omarelsobkey/Power-Supply/PCB/+V,_15,_5,_-5,_-15,_-V_2.png

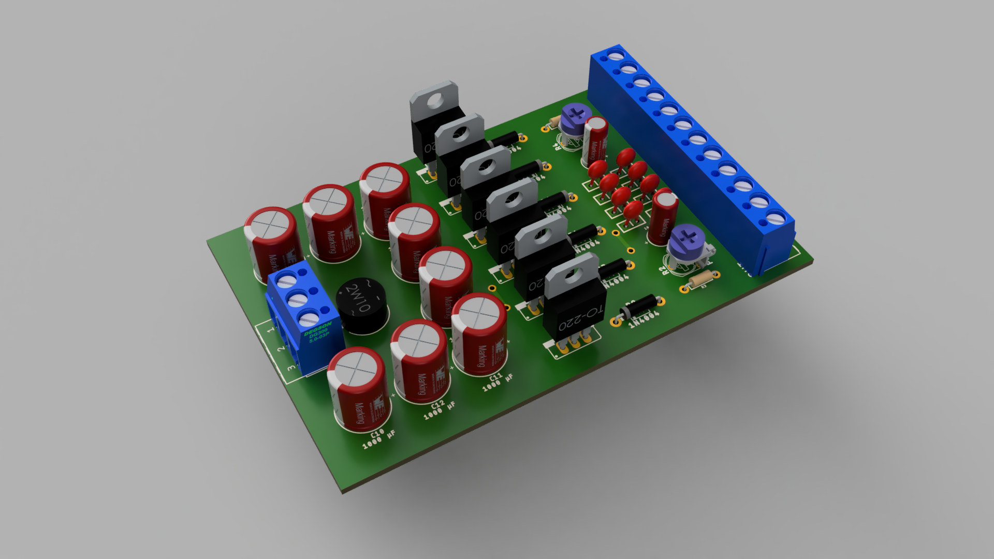
PCB/+V,_15,_5,_-5,_-15,_-V_2.png
