omarelsobkey/Power-Supply/PCB/+V, 15, 5, -5,-15, -V_1.png

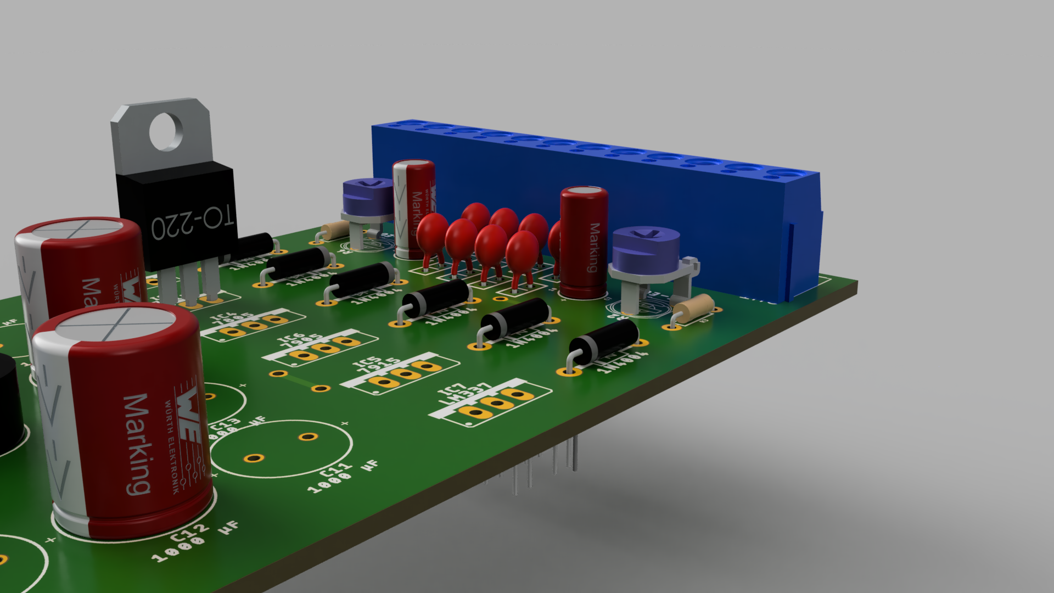
PCB/+V, 15, 5, -5,-15, -V_1.png
