omarelsobkey/Power-Supply/PCB/Done.jpeg

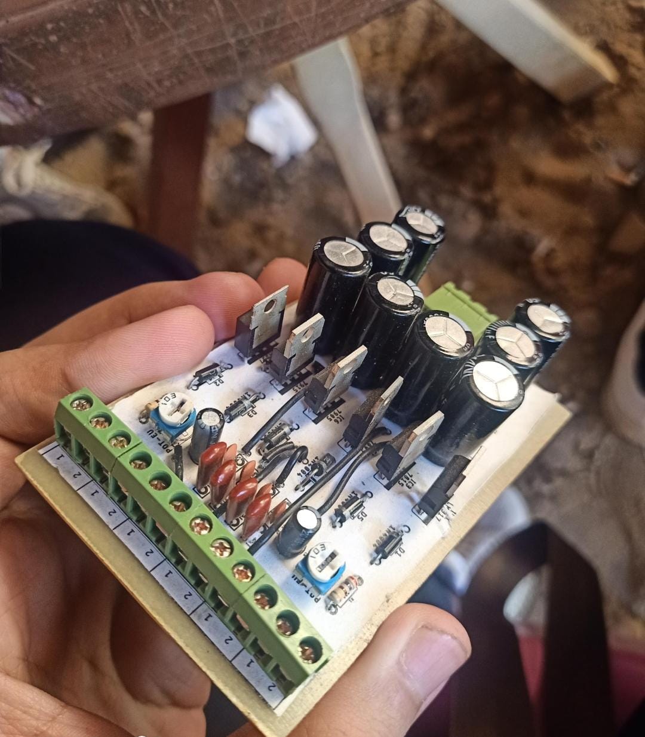
PCB/Done.jpeg
