omarelsobkey/Power-Supply/PCB/top.png

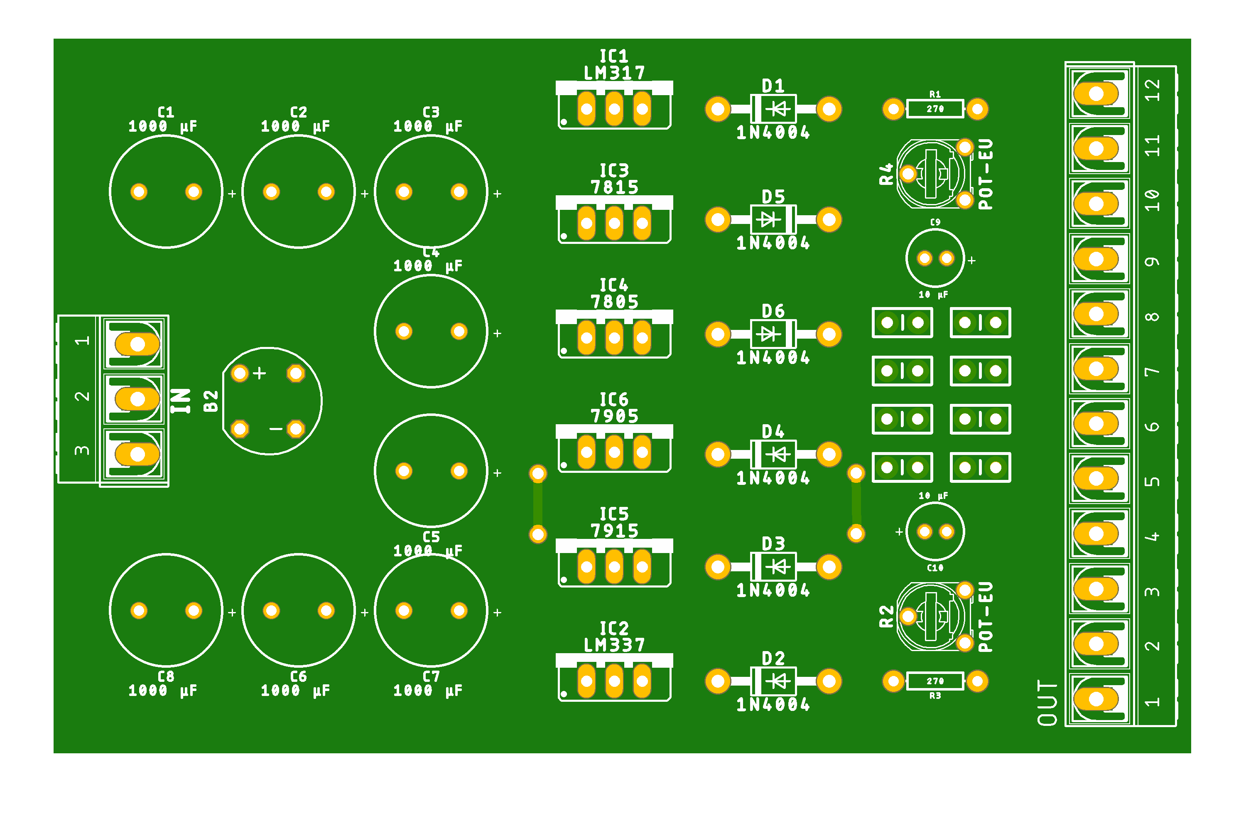
PCB/top.png
