omarelsobkey/Power-Supply/(list of files, drawings)

Other design files:
Simulation/+V, 15, 5, -5, -15, -V.ms14
