omarelsobkey/Power-Supply/PCB/Variable and Constant.brd

## EAGLE design PCB/Variable and Constant.brd (2021-09-05)

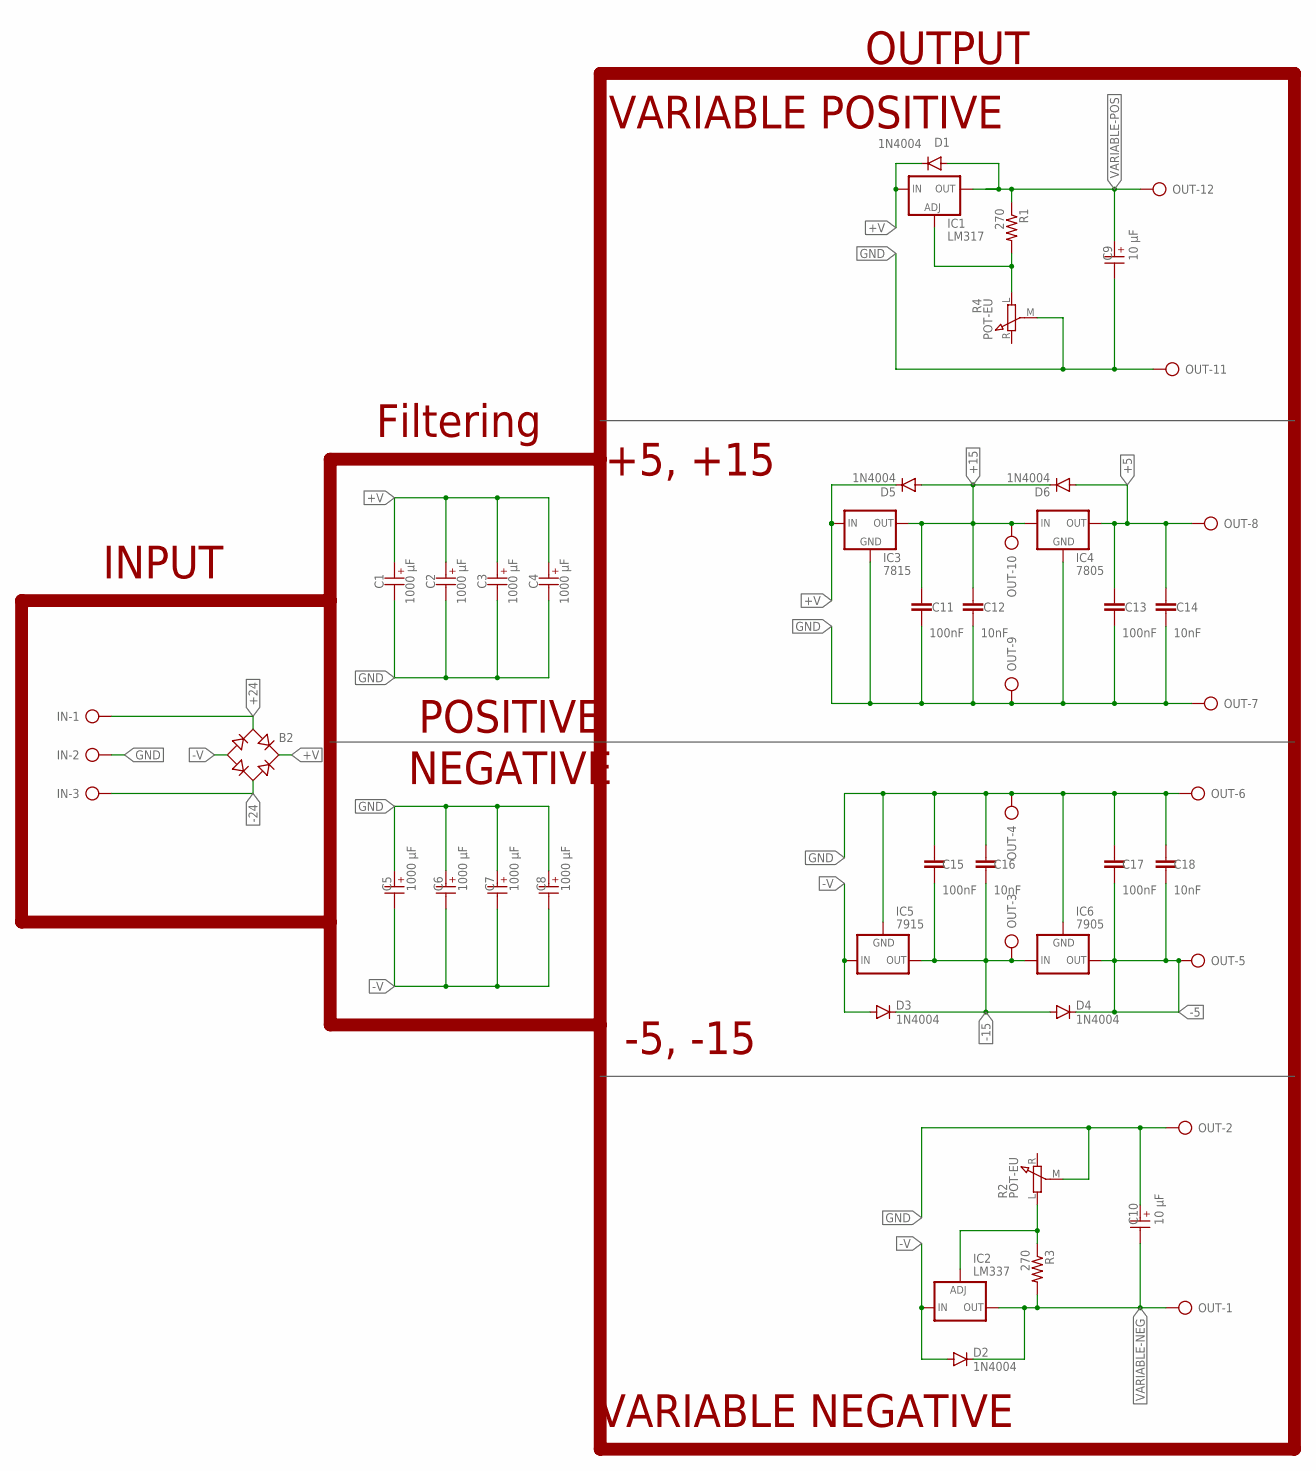
[picture p17: schematic Variable and Constant.sch]

Parts:
B2: RB1A
C1, C2, C3, C4, C5, C6, C7, C8: 1000 µF; WCAP-ATG8_10X12.5(DXL)
C9, C10: 10 µF; WCAP-ATG8_5X11(DXL)
C11, C13, C15, C17: 100nF; CAP-PTH-SMALL-KIT
C12, C14, C16, C18: 10nF; CAP-PTH-SMALL-KIT
D1, D2, D3, D4, D5, D6: 1N4004; DO41-10
IC1: LM317; 317TS
IC2: LM337; 337TS
IC3: 7815; 78XXS
IC4: 7805; 78XXS
IC5: 7915; 79XXS
IC6: 7905; 79XXS
IN: AK500/3-H
OUT: AK500/12-H
R1, R3: 270; AXIAL-0.3
R2, R4: POT-EU; RM-065

Connections:
+5: C13.1, C14.1, D6.A, IC4.OUT, OUT.8
+15: C11.1, C12.1, D5.A, D6.C, IC3.OUT, IC4.IN, OUT.10
+24: B2.AC1, IN.1
+V: B2.+, C1.1 (+), C2.1 (+), C3.1 (+), C4.1 (+), D1.C, D5.C, IC1.3 (IN), IC3.IN
-5: C17.2, C18.2, D4.C, IC6.OUT, OUT.5
-15: C15.2, C16.2, D3.C, D4.A, IC5.OUT, IC6.IN, OUT.3
-24: B2.AC2, IN.3
-V: B2.-, C5.2 (-), C6.2 (-), C7.2 (-), C8.2 (-), D2.A, D3.A, IC2.2 (IN), IC5.IN
GND: C1.2 (-), C2.2 (-), C3.2 (-), C4.2 (-), C5.1 (+), C6.1 (+), C7.1 (+), C8.1 (+), C9.2 (-), C10.1 (+), C11.2, C12.2, C13.2, C14.2, C15.1, C16.1, C17.1, C18.1, IC3.GND, IC4.GND, IC5.GND, IC6.GND, IN.2, OUT.2, OUT.4, OUT.6, OUT.7, OUT.9, OUT.11, R2.M, R4.M
unnamed: IC2.1 (ADJ), R2.L, R3.P$1 (1)
unnamed: IC1.1 (ADJ), R1.P$2 (2), R4.L
VARIABLE-NEG: C10.2 (-), D2.C, IC2.3 (OUT), OUT.1, R3.P$2 (2)
VARIABLE-POS: C9.1 (+), D1.A, IC1.2 (OUT), OUT.12, R1.P$1 (1)

Notes on the sheet:
INPUT
Filtering
OUTPUT
VARIABLE POSITIVE
+5, +15
-5, -15
VARIABLE NEGATIVE
POSITIVE
NEGATIVE

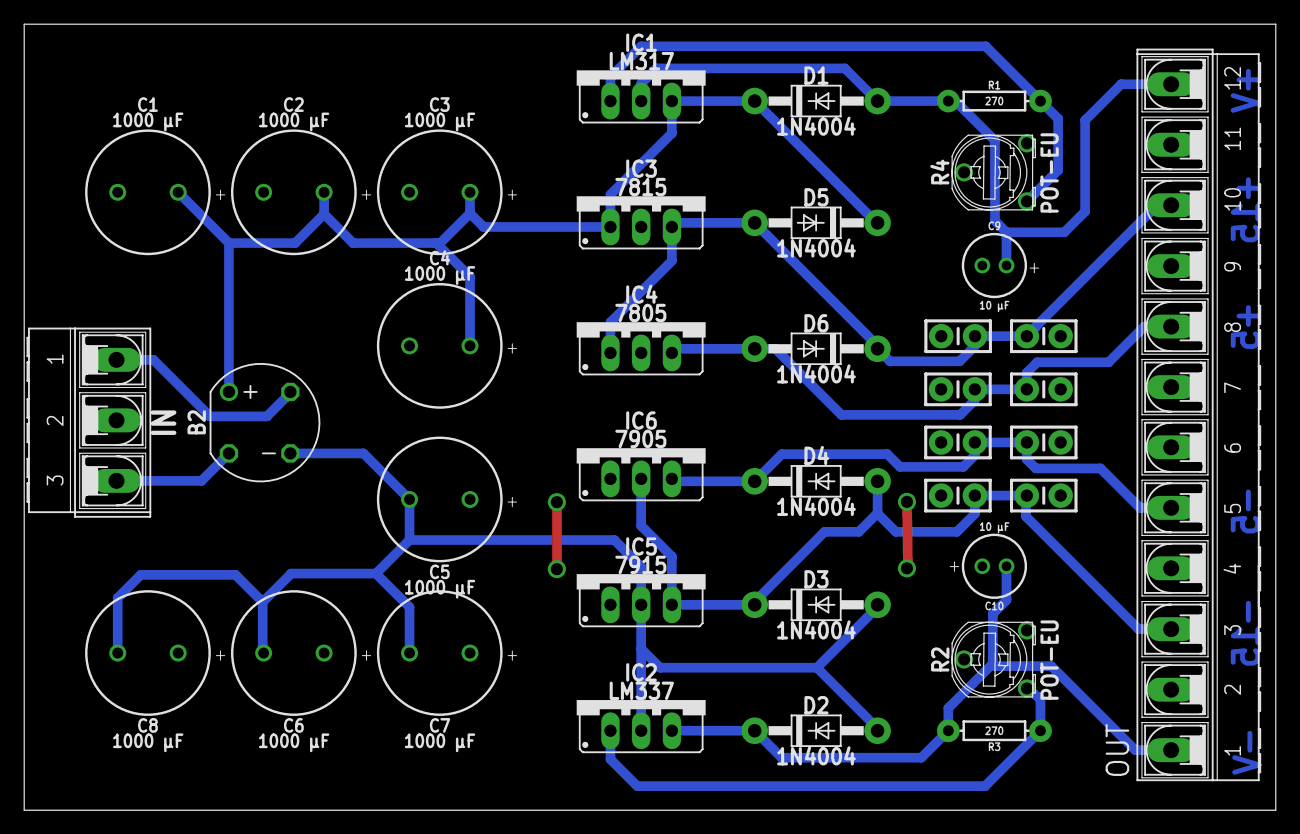
[picture p18: board Variable and Constant.brd from above]

Board: 2 copper layers, 103.5 x 65.0 mm, 37 parts (0 on the bottom side), 13 nets.
