omarelsobkey/Power-Supply/(notices)

Notices in the files:
parts and their libraries:
Aluminium Electrolyt Capacitors: Copyright: Würth Elektronik
SparkFun-Capacitors: Licensing: Creative Commons ShareAlike 4.0 International - https://creativecommons.org/licenses/by-sa/4.0
